cuikuikui-xian/drawing-optimization/condenser_review_schematic.png

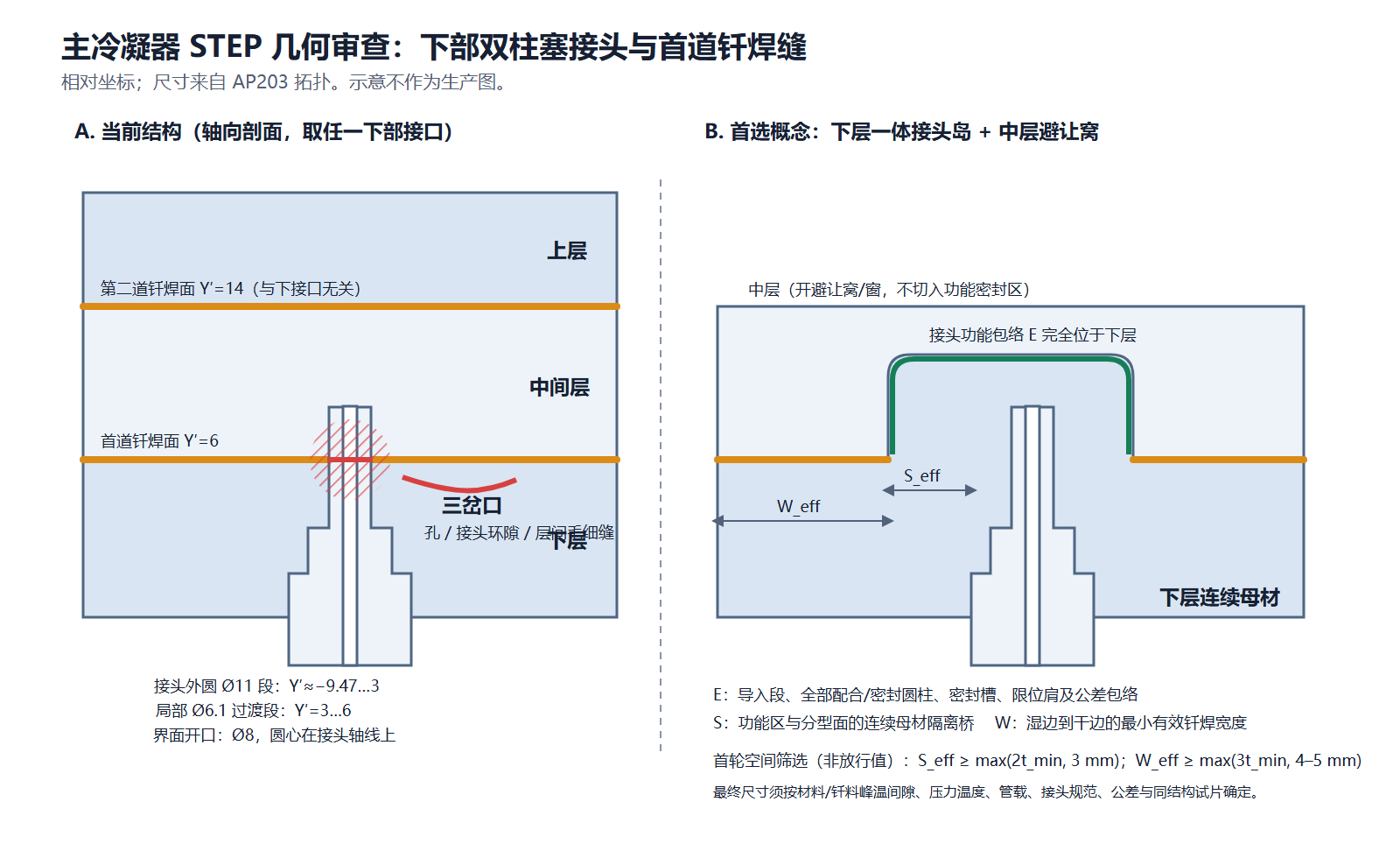
condenser_review_schematic.png
