cuikuikui-xian/drawing-optimization/native_bottom.bmp

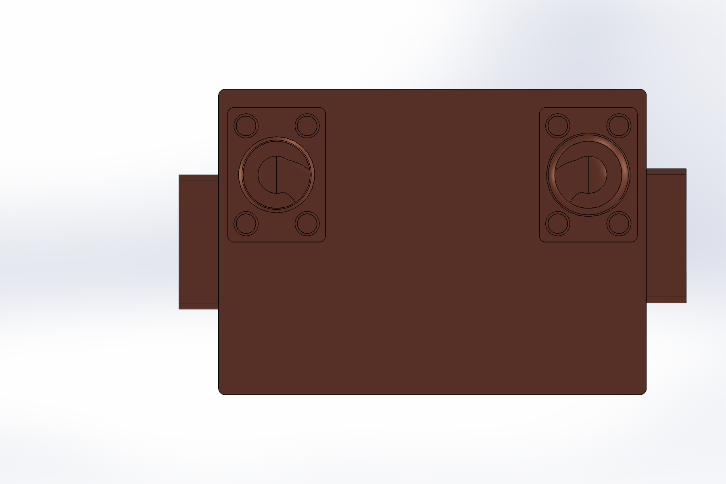
native_bottom.bmp
