cuikuikui-xian/drawing-optimization/native_front.bmp

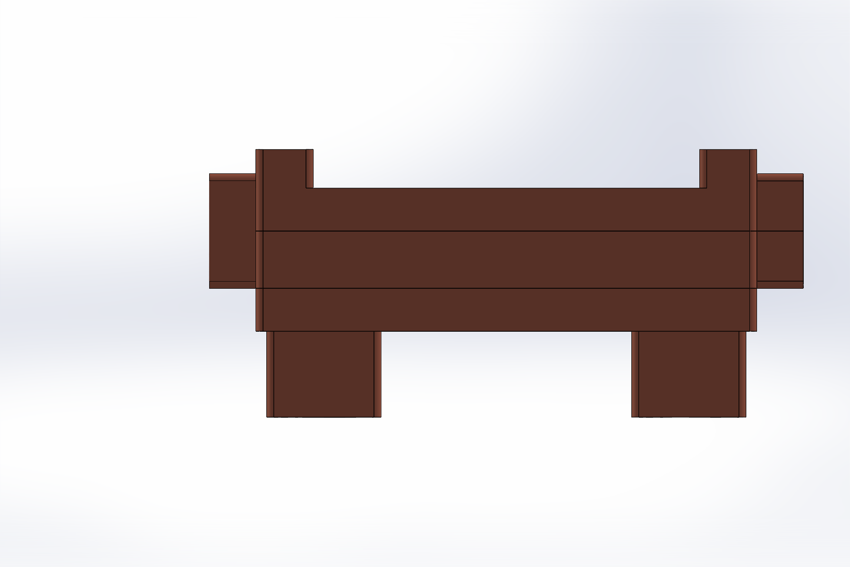
native_front.bmp
