cuikuikui-xian/drawing-optimization/native_isometric.bmp

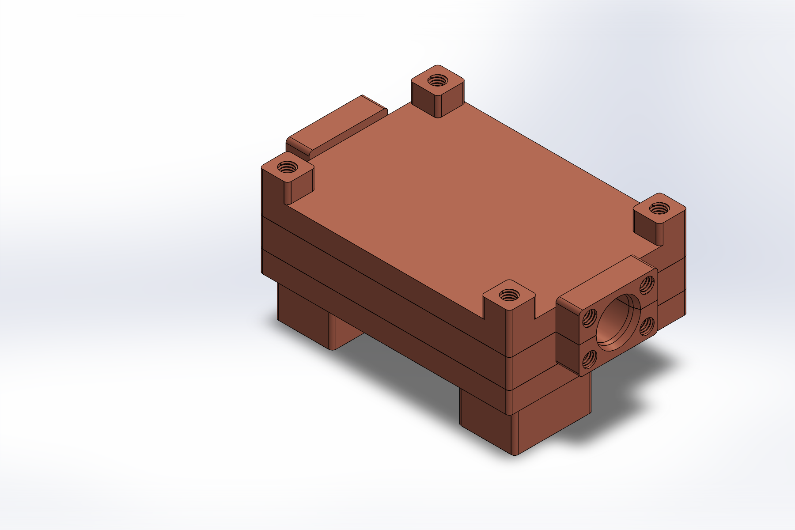
native_isometric.bmp
