cuikuikui-xian/drawing-optimization/solidworks_geometry.bmp

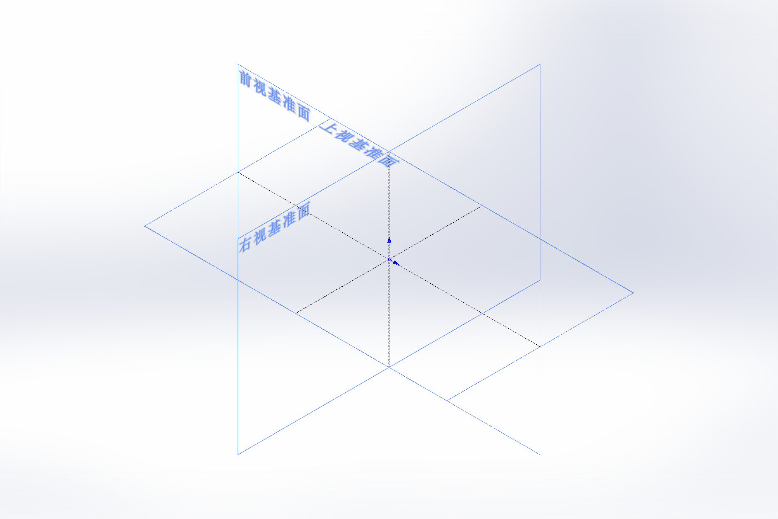
solidworks_geometry.bmp
