cuikuikui-xian/drawing-optimization/指定漏点直观解释.png

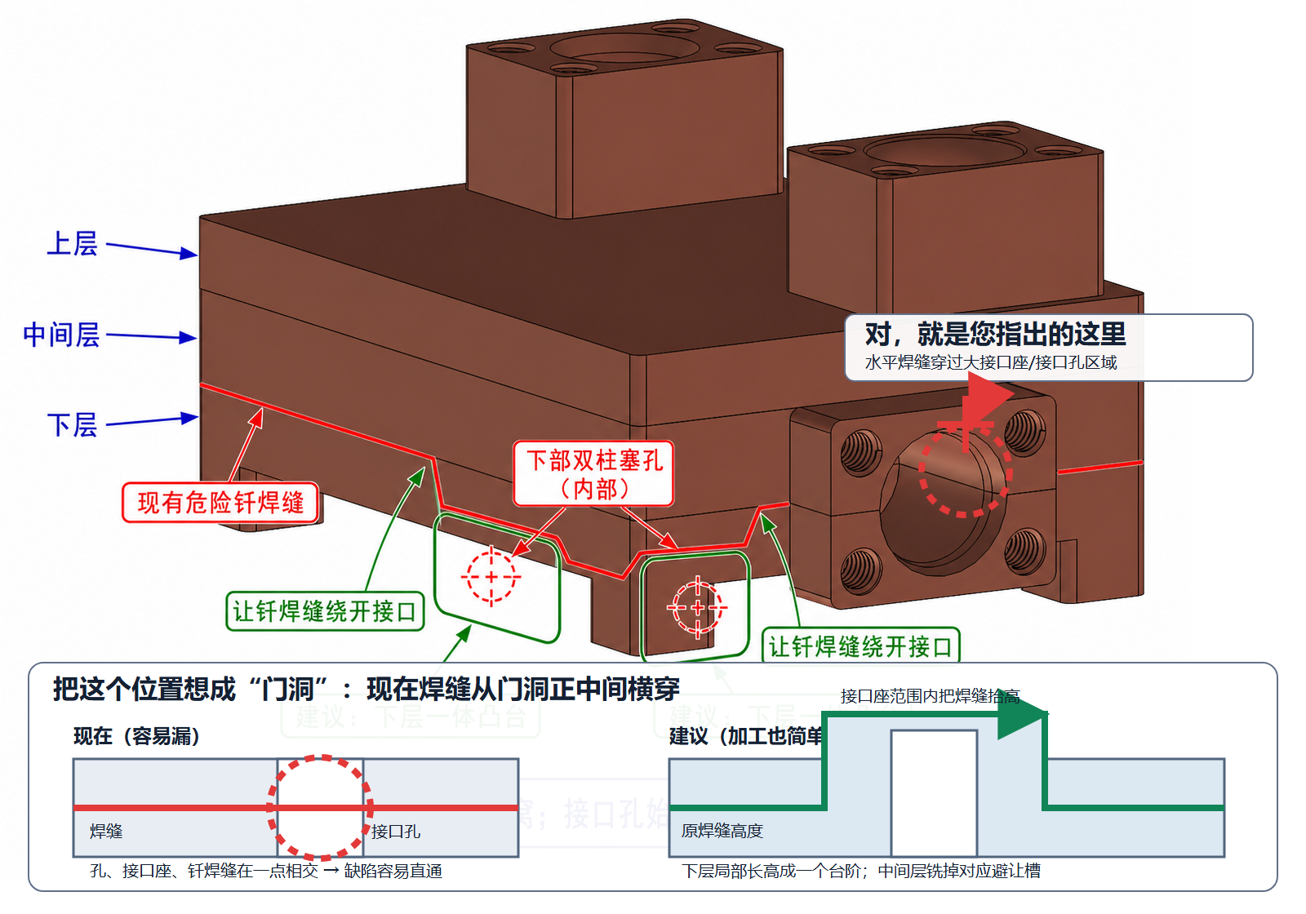
指定漏点直观解释.png
