cuikuikui-xian/drawing-optimization/用户图片解释标注.png

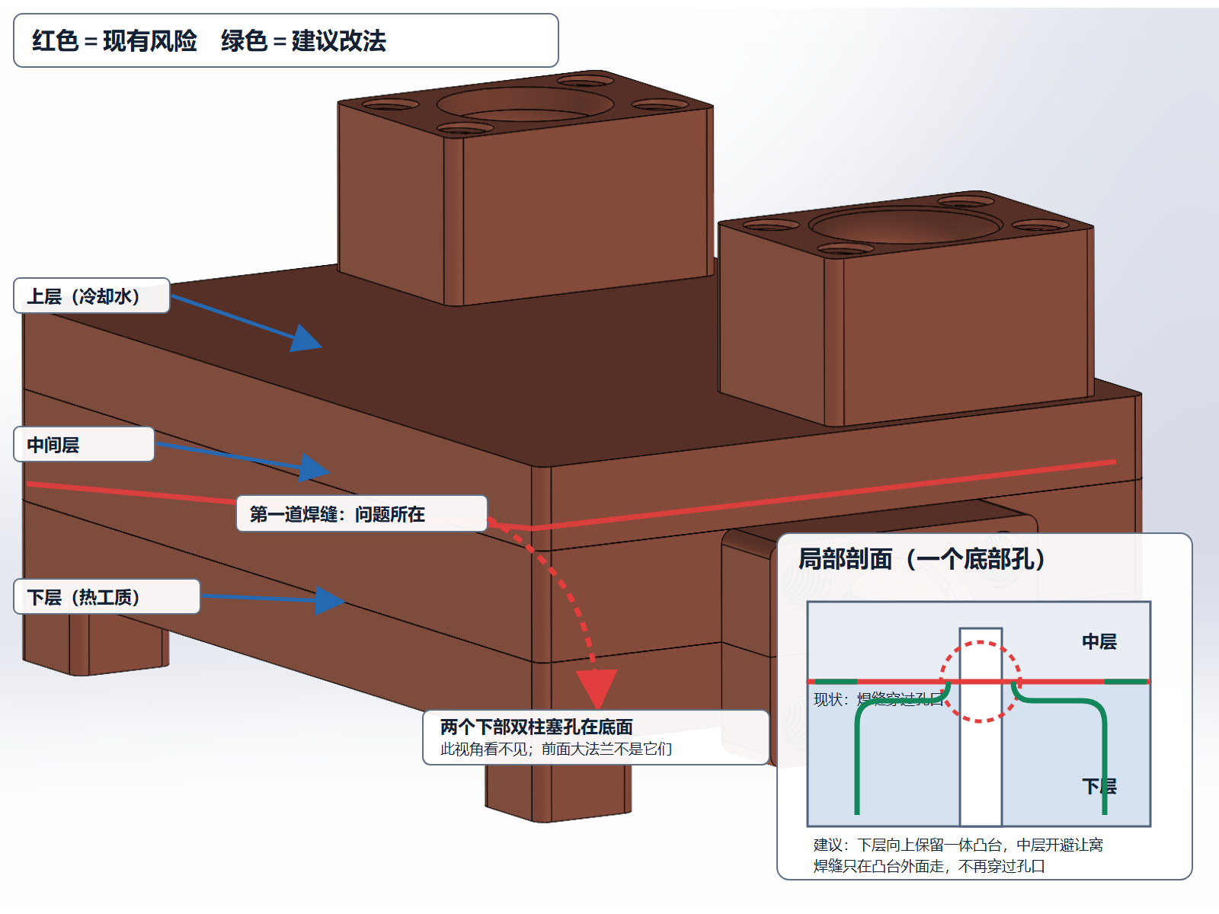
用户图片解释标注.png
