cuikuikui-xian/drawing-optimization/condenser_review.STEP

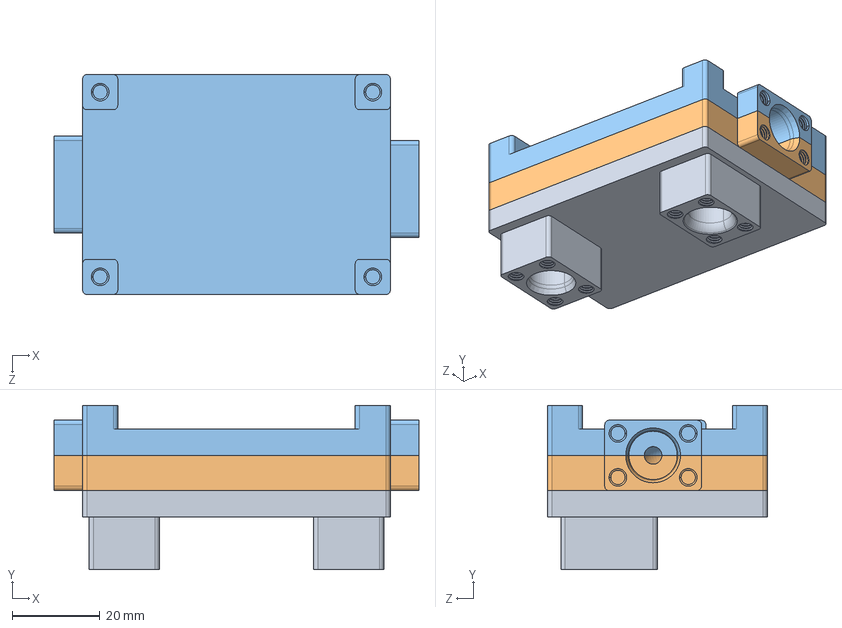
[picture p8: CAD file, 2026-09-24]
condenser_review.STEP
83.0 x 37.4 x 50.0 mm
主冷凝器-冷板下层-正样
主冷凝器-冷板中间层-正样
主冷凝器-冷板上层-正样
