cuikuikui-xian/drawing-optimization/native_review_copy.SLDASM

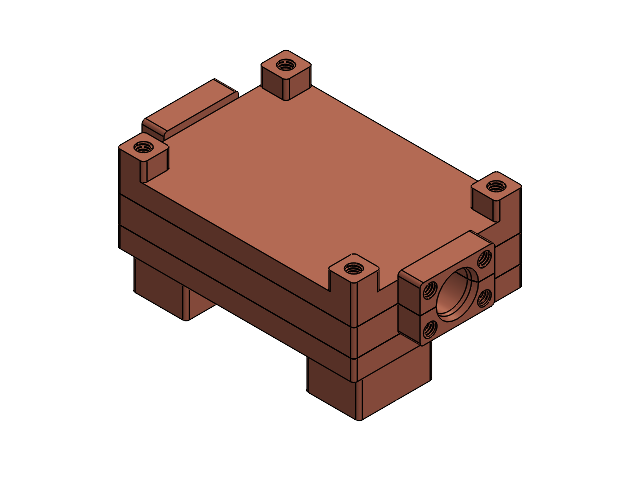
[picture p9: CAD file, 2026-09-24]
native_review_copy.SLDASM
主冷凝器-冷板下层-正样
主冷凝器-冷板中间层-正样
主冷凝器-冷板上层-正样
